rsmith4321/fpv-audio-recorder/hardware/recorder-holder/render-holder-with-board.png

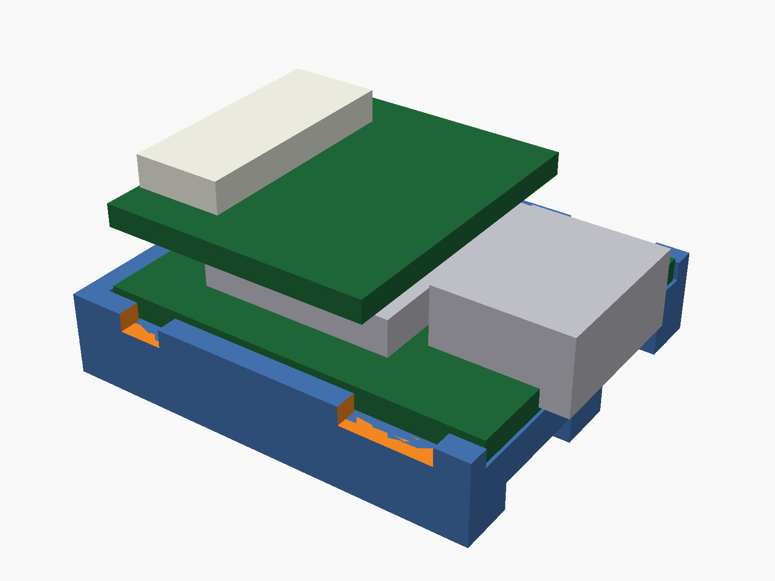
hardware/recorder-holder/render-holder-with-board.png
