rsmith4321/fpv-audio-recorder/hardware/recorder-holder/render-holder.png

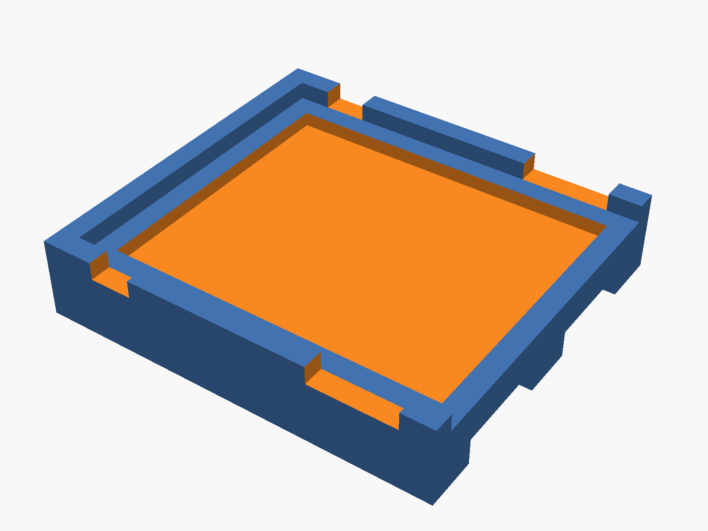
hardware/recorder-holder/render-holder.png
