rsmith4321/fpv-audio-recorder/hardware/recorder-holder/v7/v7-cutaway.png

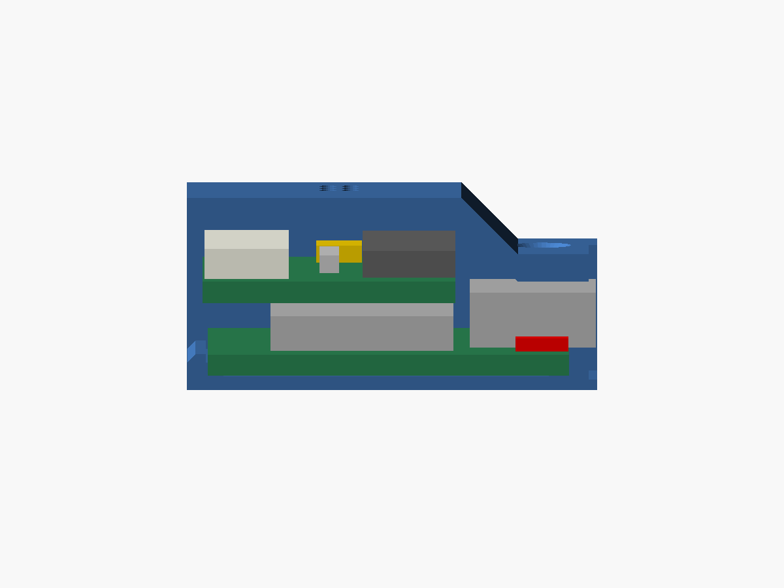
hardware/recorder-holder/v7/v7-cutaway.png
