rsmith4321/fpv-audio-recorder/hardware/recorder-holder/recorder-holder-v2.stl

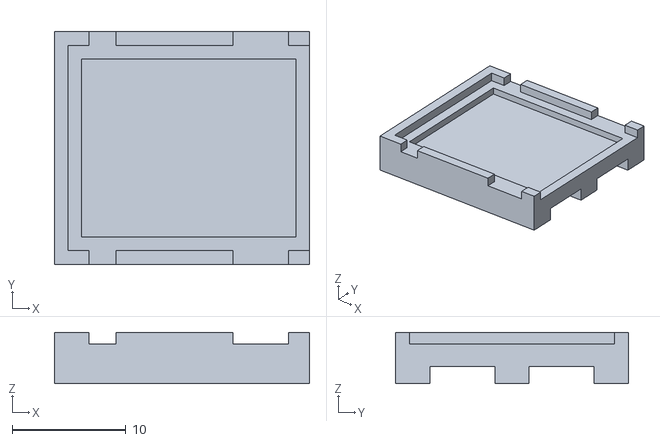
[picture p27: CAD file, 2026-10-10]
hardware/recorder-holder/recorder-holder-v2.stl
22.5 x 20.5 x 4.50
