rsmith4321/fpv-audio-recorder/hardware/recorder-holder/v7/recorder-case-v7-sleeve.3mf

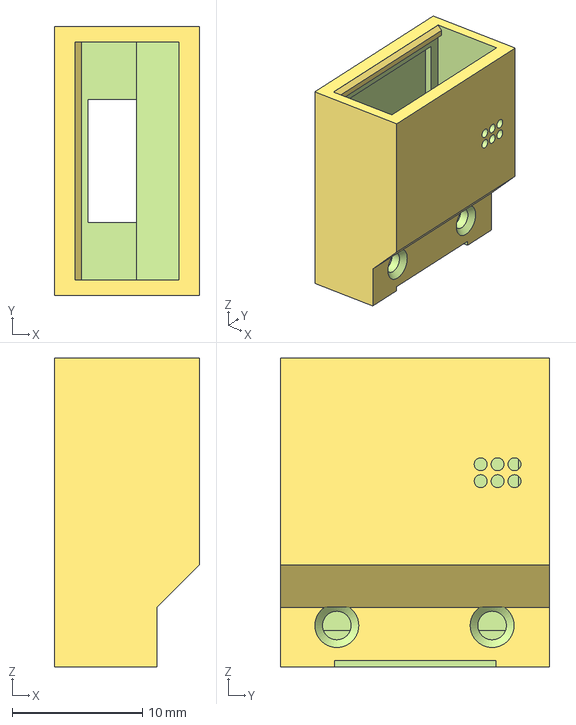
[picture p28: CAD file, 2026-10-18]
hardware/recorder-holder/v7/recorder-case-v7-sleeve.3mf
11.2 x 20.7 x 23.8 mm
