rsmith4321/fpv-audio-recorder/hardware/recorder-holder/v6.5/recorder-case-v6.5-bottom-flat.stl

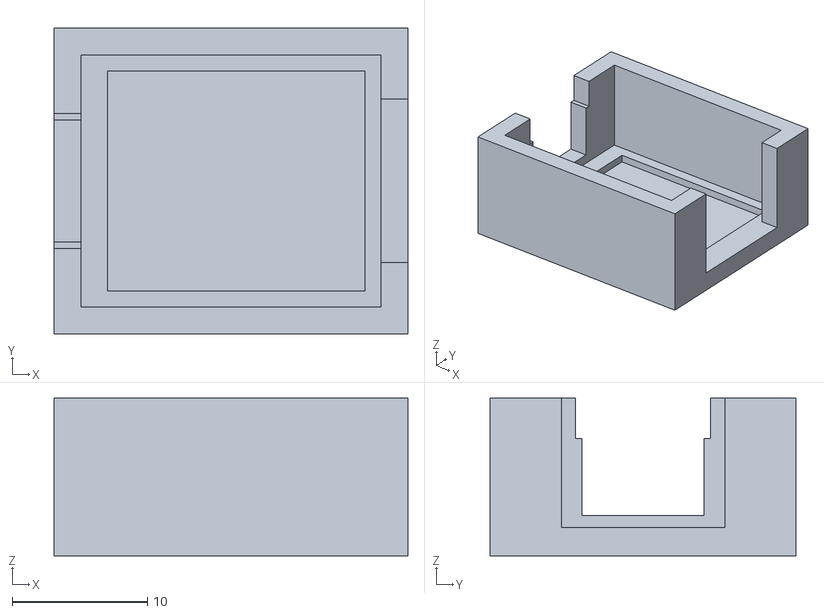
[picture p31: CAD file, 2026-10-17, an earlier design]
hardware/recorder-holder/v6.5/recorder-case-v6.5-bottom-flat.stl
26.2 x 22.7 x 11.7
