rsmith4321/fpv-audio-recorder/(list of files, cad)

Other CAD files:
hardware/recorder-holder/v6.5/recorder-case-v6.5.scad
hardware/recorder-holder/v7/recorder-case-v7-sleeve.stl
