rsmith4321/fpv-audio-recorder/hardware/recorder-holder/v7/RELEASE-NOTES.md

# Recorder case V7 (pre-release)

A one-piece slide-in TPU sleeve for the camera-free XIAO ESP32S3 Sense recorder running the SD-free firmware v2. No lid and no glue: the board stack slides in from the open back and clicks over a small floor detent.

**Flight update, 2026-10-22:** the printed V7 sleeve flew with the SD-free firmware v2 recorder installed. See the [flight-test report](../../../docs/flight-test-2026-10-22.md). The case design and release assets are unchanged; the download remains a pre-release.

- **23.76 × 20.68 × 11.18 mm, 2.15 g** in TPU (V6.5: two parts, about 4.1 g).
- No microSD access. The recorder now stores audio in internal flash and shows up as a USB drive.
- USB window sized to the receptacle (9.44 × 3.71 mm) with a 12.4 mm overmold recess so cable plugs seat fully.
- Mic grille (2 × 3 holes, 1.0 mm) and 2.2 mm poke holes for the B (BOOT) and R (RESET) buttons.
- 1.2 mm side walls; the zip-tie tab from the first draft was removed.
- STL, 3MF (opens standing in Bambu Studio), a socket-removed STL variant, editable OpenSCAD source, previews, photos, dimensions and print notes.

**Print it standing, USB face down, as saved.** Dry the TPU first to avoid stringing; my first print, laid flat with damp filament, came out stringy.

Remaining validation: repeated-flight retention, measured vibration, wind-noise protection and in-flight temperature.

I'm new to 3D printing, so there's probably a better way to design this case. If you come up with a different or improved design, please submit a pull request! Issues with ideas, photos, or printable files are welcome too.
