rsmith4321/fpv-audio-recorder/(commit log)

2026-10-04 Document verified Easy Eject bench setup and mounting
2026-10-04 Document prototype assembly with real build photographs
2026-10-08 Document Flywoo UART1 connector installation plan
2026-10-10 Document harness assembly, VHB mount and first arm/disarm recordings
    Adds build photos 08-16 (metadata stripped), the UART1 MSP setup, the
    props-off and indoor hand-held test results, and the microphone level
    findings.
2026-10-10 Add 3D-printable recorder holder (untested)
    OpenSCAD source, STL and renders for a shallow tray that grips the
    XIAO ESP32S3 Sense by its bottom board. Dimensions come from Seeed's
    official 3D model. Not yet printed or test-fitted.
2026-10-17 Release V6.5 TPU recorder case with wider USB and SD access
2026-10-18 Pre-release V7 recorder case and firmware v2 (bench-tested, flight test pending)
    - hardware/recorder-holder/v7: one-piece slide-in TPU sleeve, 23.76 x 20.68 x 11.18 mm,
    2.15 g. STL, 3MF, socket-removed STL, OpenSCAD source, previews, photos,
    specifications, mesh checks and checksums. V6.5 stays as the previous case.
    - firmware/v2: SD-free recorder firmware. Read-only USB drive FPVAUDIO with one
    timestamped WAV per flight, oldest audio overwritten, B-button format. Source,
    flashable image, host tools (download, DJI video sync) and host test.
    - README, firmware and case indexes, and the Pages site updated.
    - firmware/latest.json unchanged (Easy Eject does not recognise v2 yet).
    Bench-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
2026-10-18 Pages: update the operating note's temperature reference
2026-10-22 Publish recorder real-flight sample and completed build milestone
